raspberrypilearning/bike-gloves/README.md

# default-project-template

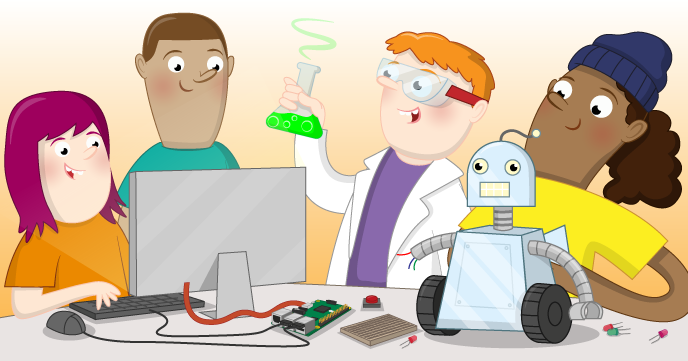
[picture p1: banner.png]
default-project-template


Find the project online at [projects.raspberrypi.org/en/projects/default-project-template](https://projects.raspberrypi.org/en/projects/default-project-template)

## Resources
For project materials and solutions, see [en/resources](https://github.com/raspberrypilearning/default-project-template/tree/master/en/resources) and [en/solutions](https://github.com/raspberrypilearning/default-project-template/tree/master/en/solutions).

## Contributing
See [CONTRIBUTING.md](CONTRIBUTING.md)

## Licence
See [LICENCE.md](LICENCE.md)

## Setting up a Crowdin project

See [CROWDIN.md](CROWDIN.md).
