raspberrypilearning/bike-gloves/en/images/circuit_challenge.jpeg

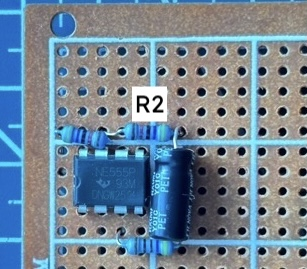
en/images/circuit_challenge.jpeg
