raspberrypilearning/bike-gloves/(list of files, drawings)

Other design files:
en/images/LED_555.fzz
