raspberrypilearning/bike-gloves/en/step_1.md

## What you will make

Create flashing bike gloves and stay safe when riding in the dark!

--- print-only ---

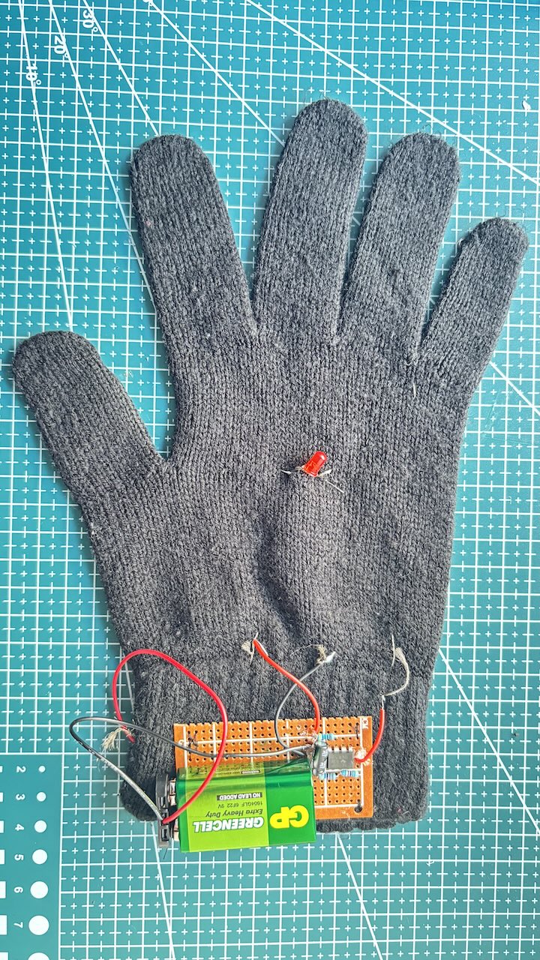
[picture p3: en/images/bike_glove.jpg]
A glove with flashing LEDs on the back, which is controlled by closing two fingers together.


--- /print-only ---

--- no-print ---

<video width="270" height="480" controls autoplay>
<source src="images/bike_glove.mp4" type="video/mp4">
</video>

--- /no-print ---

### You will need:
- Breadboard
- 2 x LED
- 2 x 555 timer
- 4 x 47 kΩ resistors
- 2 x 470 Ω or 330 Ω resistor
- 2 x 10 µF capacitor
- Jumper cables
- 9V battery
- PP3 connector (battery snap)
- Prototype circuit board
- Conductive thread
- Needle
- A pair of gloves
- Soldering kit

**Optional**:
- Potentiometer
- Light dependent resistor (LDR)
- Extra 47 kΩ resistors
