raspberrypilearning/bike-gloves/en/step_2.md

## Make a prototype

### Power the 555 timer

With the notch on the left, the 555 timer pins are:

1: Ground
2: Trigger
3: Output
4: Reset
5: Control
6: Threshold
7: Discharge
8: VCC

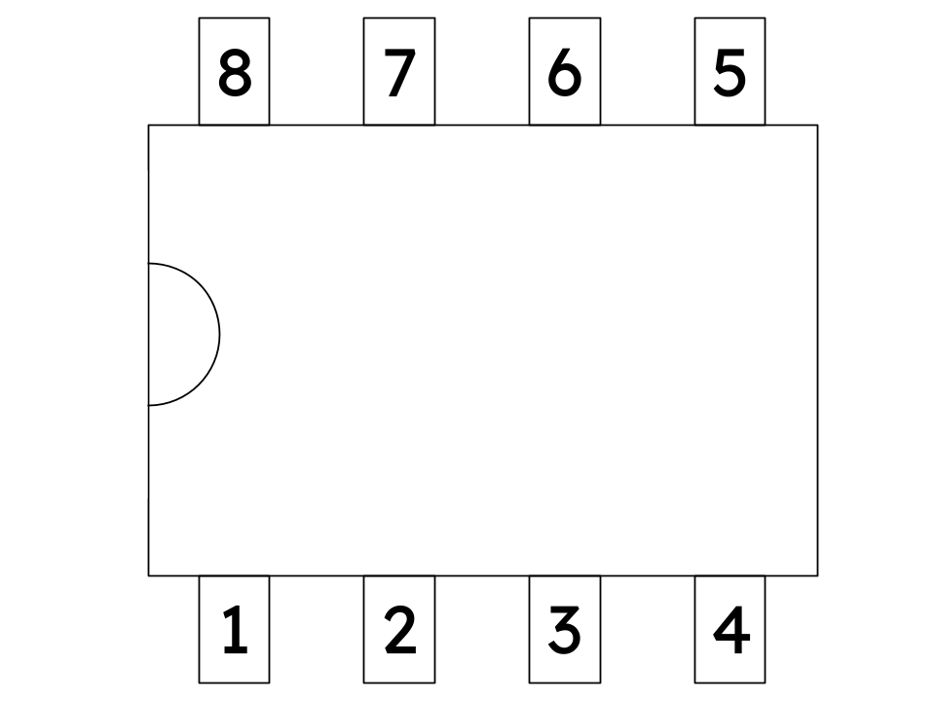
[picture p4: en/images/555_timer_pinout.png]
A 555 timer pinout. Pins 1 to 4 are at the bottom from left to right and pins 5 to 8 are at the top from right to left.


--- task ---

Put the 555 timer in the middle of the breadboard, across the centre gap.

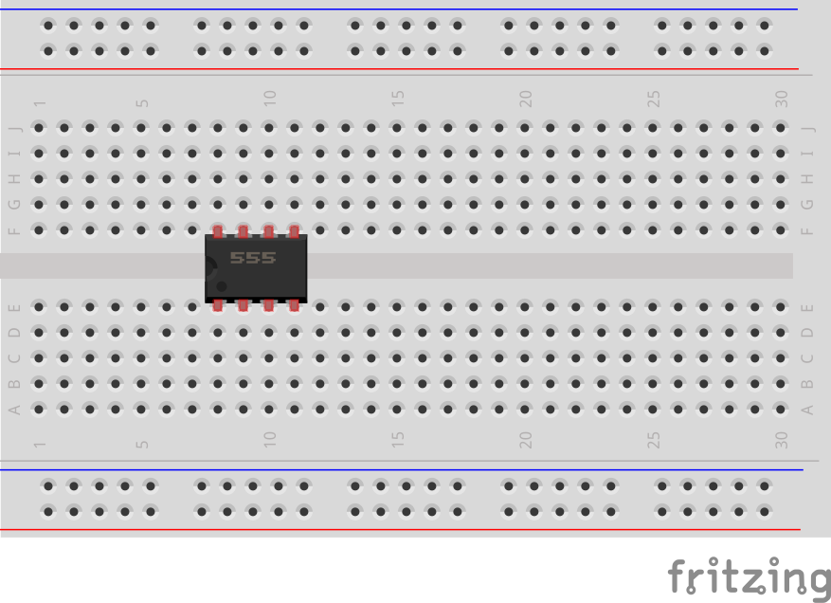
[picture p5: en/images/LED_555-9.png]
A 555 timer positioned across the gap in the middle of a breadboard, with pin 1 in E8 and pin 8 in F8.


--- /task ---

--- task ---

Connect the 555 timer power pins.

Connect **pin 1** to the ground rail.

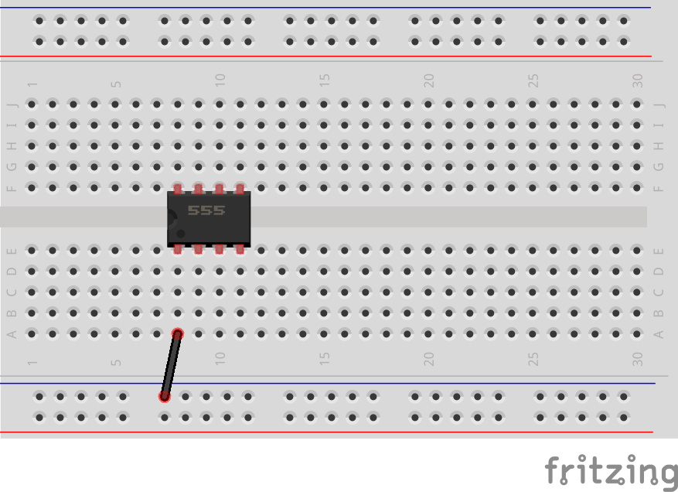
[picture p6: en/images/LED_555-8.png]
A jumper wire has been added to connect A8 to the ground rail.


Connect **pin 8** to the positive rail.

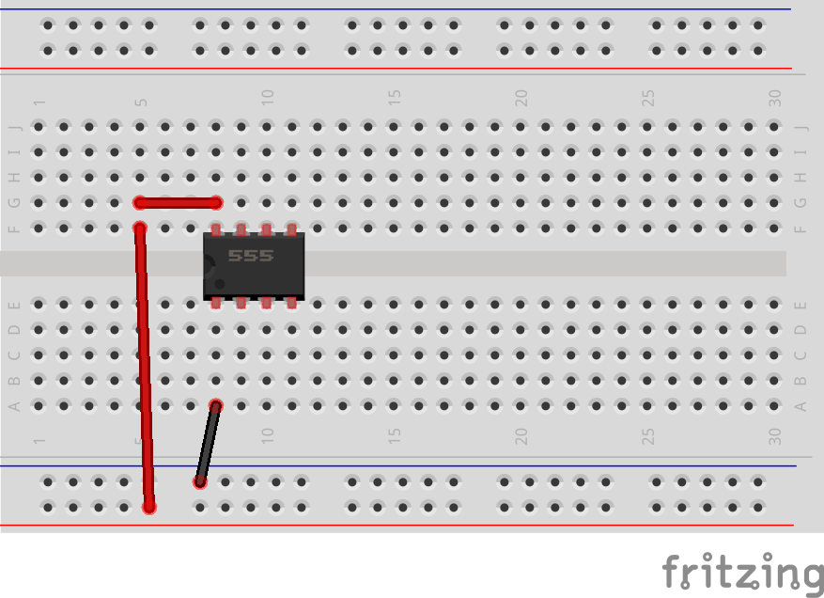
[picture p7: en/images/LED_555-7.png]
Two jumper wires have been added to connect G8 to G5 and F5 to the positive rail.


Connect **pin 4 (reset)** to the positive rail (so it is always enabled).

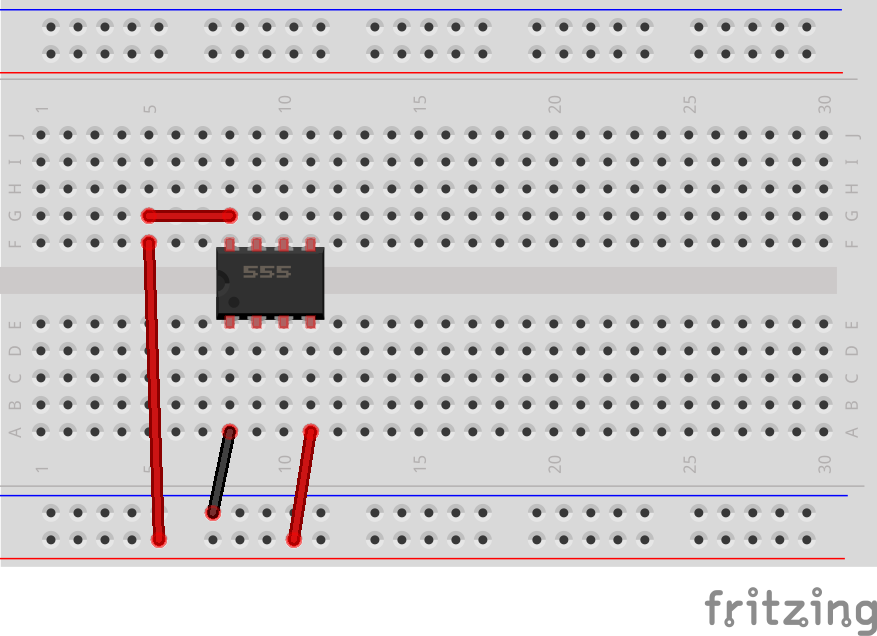
[picture p8: en/images/LED_555-6.png]
A jumper wire has been added to connect A11 to the positive rail.


You will add the battery to the breadboard at the end.

--- /task ---

### Build the timing network

--- task ---

Join **pins 2** and **6** (**trigger** and **threshold**) together.

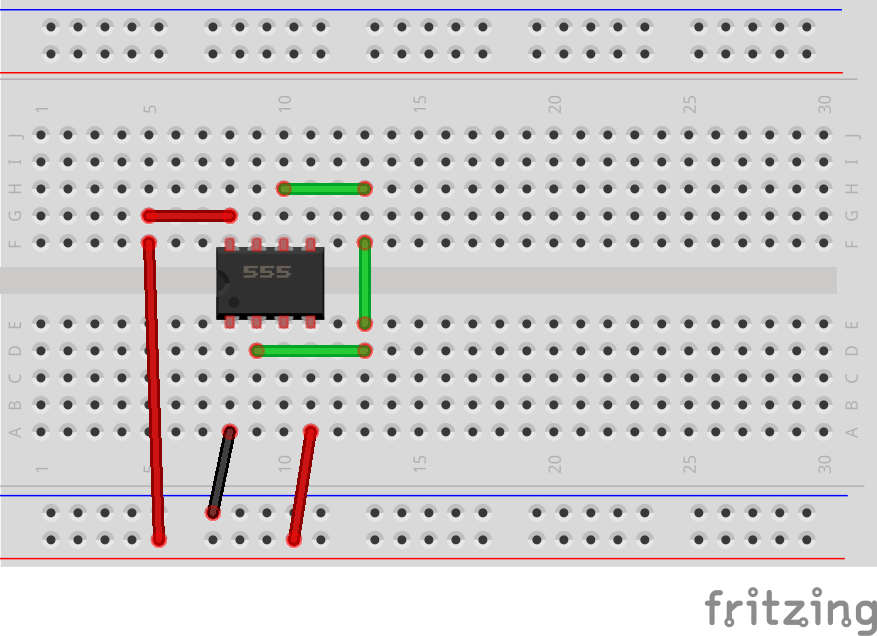
[picture p9: en/images/LED_555-5.png]
Three jumper wires have been added to connect D9 to D13, E13 to F13, and H13 to H10.


--- /task ---

--- task ---

Add two 47kΩ resistors.

The first should connect the positive rail to **pin 7**.

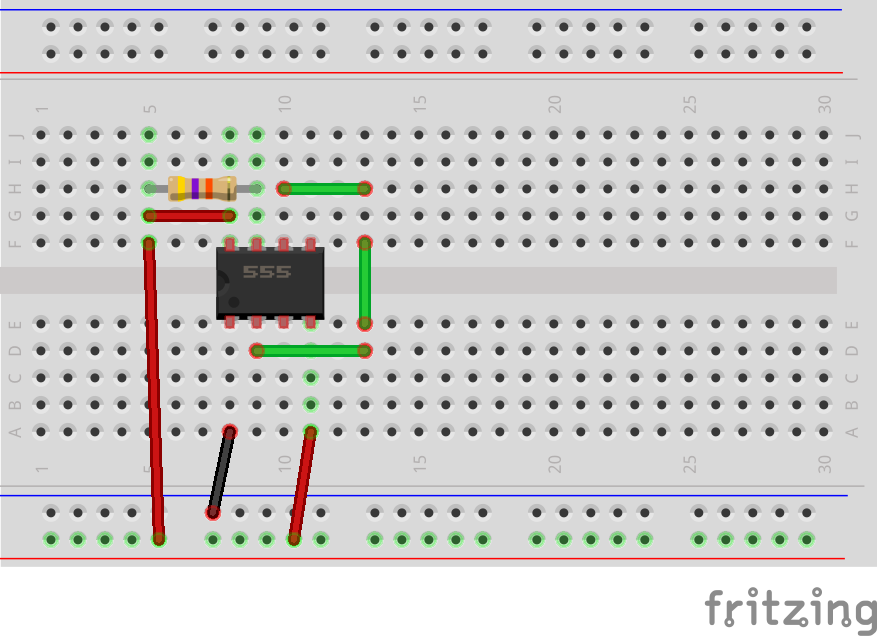
[picture p10: en/images/LED_555-4.png]
A 47kΩ resistor has been added connecting H5 and H9.


The second should connect **pin 7** to **pins 2** and **6** (the joined pins).

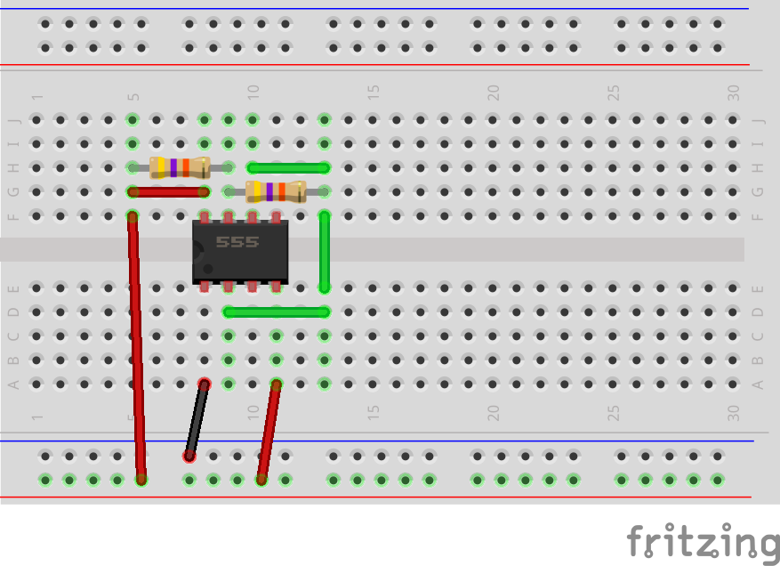
[picture p11: en/images/LED_555-3.png]
A 47kΩ resistor has been added connecting G9 and G13.


--- /task ---

--- task ---

Add the capacitor (10µF).

Connect the positive (long) leg to the joined **pins 2** and **6**.

Connect the negative (short) leg to the ground rail.

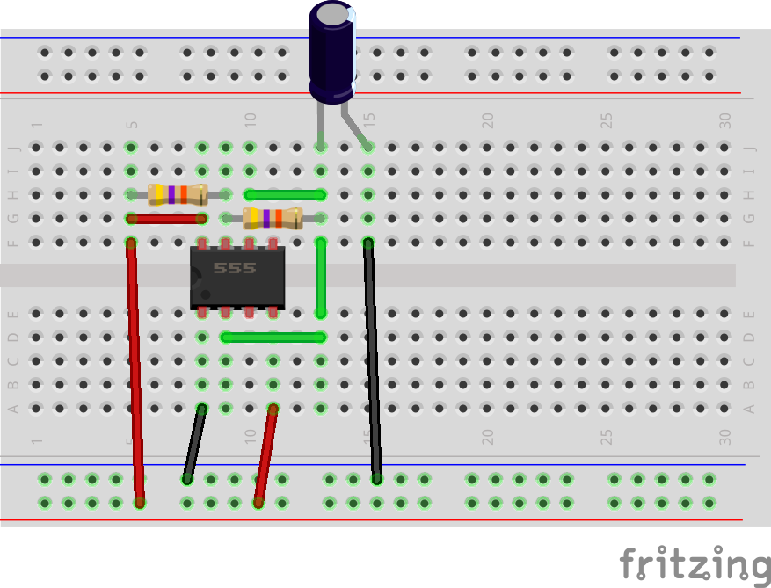
[picture p12: en/images/LED_555-2.png]
A 10µF capacitor has been added, with the long leg in J13 and the short leg in J15. A jumper wire has been added to connect F15 to the ground rail.


--- /task ---

### Add the LED and resistor

--- task ---

Connect one side of the 470Ω resistor to **pin 3 (output)**, and connect the other side of the resistor to the long leg of the LED.

Connect the short leg of the LED to the ground rail.

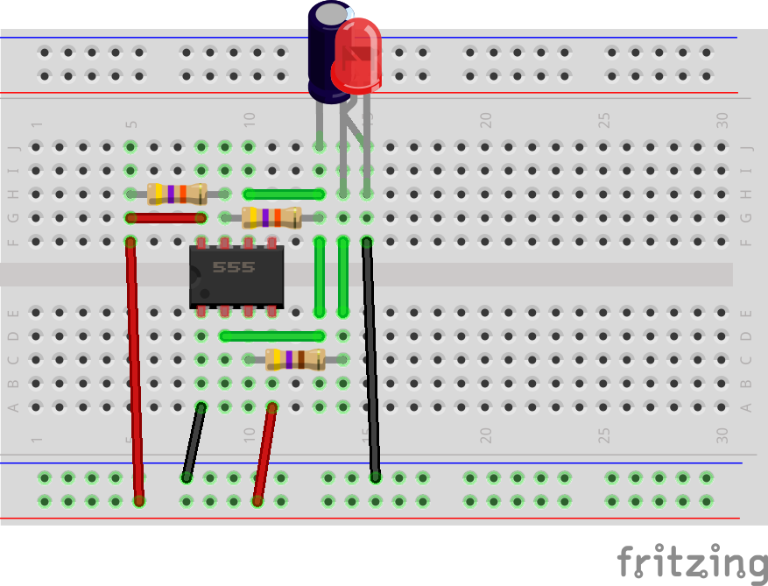
[picture p13: en/images/LED_555-1.png]
An LED has been added, with the long leg in H14 and the short leg in H15, and a resistor has been added in C10 and C14.


--- /task ---

--- task ---

**Test:**

Add the 9V battery and connect the power and ground rails.

Connect the positive terminal of the battery to the red positive rail.

Connect the negative terminal of the battery to the blue ground rail.

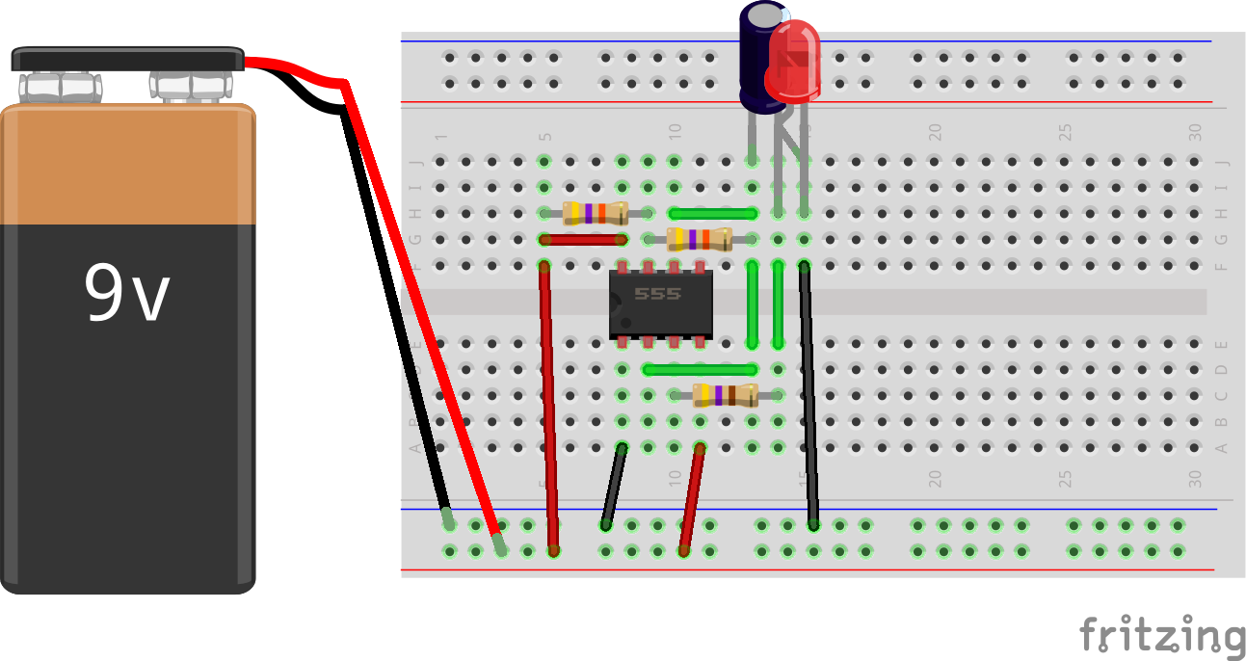
[picture p14: en/images/LED_555.png]
A 9V battery has been connected to the power rails with jumper wires.


The LED should blink once every second — great for making you more visible to other road users!

--- no-print ---

<video width="480" height="270" controls>
<source src="images/LED_555.mp4" type="video/mp4">
</video>

--- /no-print ---

**Debug:** Unplug the battery and check that:

- **Pin 1** is connected to the ground rail, **pin 8** is connected to the positive rail, and **pin 4** is connected to the positive rail
- **Pins 2** and **6** are joined correctly
- The capacitor legs are the correct way around
- The LED legs are the correct way around

--- /task ---
