raspberrypilearning/bike-gloves/en/step_3.md

## Add to your gloves

If you are new to soldering, check out our [Getting started with soldering](https://projects.raspberrypi.org/en/projects/getting-started-with-soldering){:target="_blank"} guide for support.

### Add the components

--- task ---

Using the breadboard as a guide, add the resistors, capacitor and the 555 timer to a prototype circuit board (PCB).

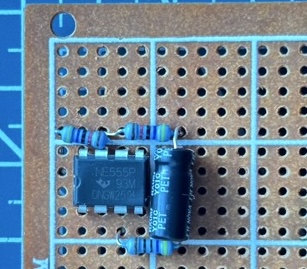
[picture p15: en/images/circuit_1.jpeg]
Components placed on the prototype circuit board.


--- /task ---

### Solder the components

--- task ---

Solder the components to the PCB. You can use resistor legs as positive and negative rails if your PCB does not have them.

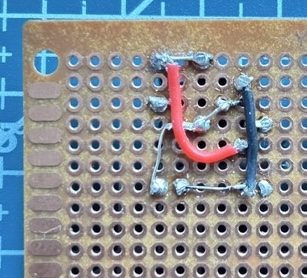
[picture p16: en/images/circuit_2.jpeg]
The back of the PCB with the components soldered.


--- /task ---

### Add the LED

--- task ---

Curl the LED legs into loops and sew them into your glove with conductive thread.

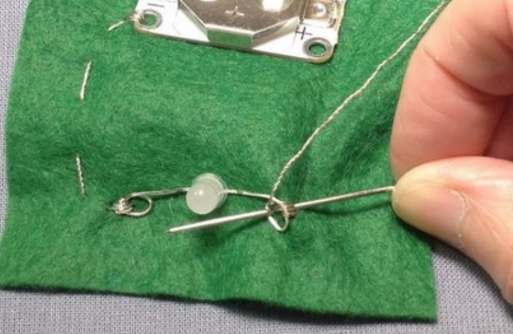
[picture p17: en/images/circuit_4.png]
Sewing the LED legs to the glove with conductive thread.


Make sure there are no sharp edges near your hand. You can trim the legs with snippers.

--- /task ---

--- task ---

Sew the thread from each leg through the back of the glove to the cuff.

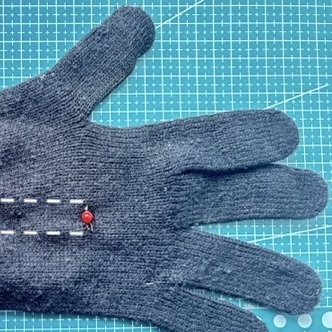
[picture p18: en/images/circuit_5.jpeg]
An example of sewing the thread from each leg through the back of the glove to the cuff.


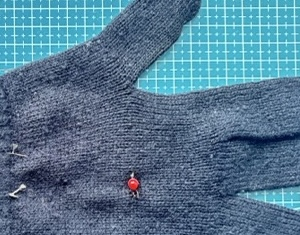
[picture p19: en/images/circuit_6.jpeg]
Conductive thread from the legs of the LED showing at the cuff.


--- /task ---

### Create a switch

--- task ---

Sew conductive thread into the thumb and the little finger of the glove. The pads of thread should touch when you bring them together.

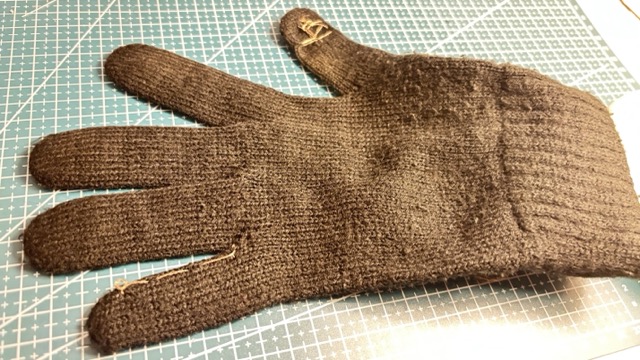
[picture p20: en/images/circuit_3.jpeg]
The glove with a conductive thread pad visible on the thumb.


--- /task ---

--- task ---

Sew the thread from each side of the switch along the back of the glove to the cuff.

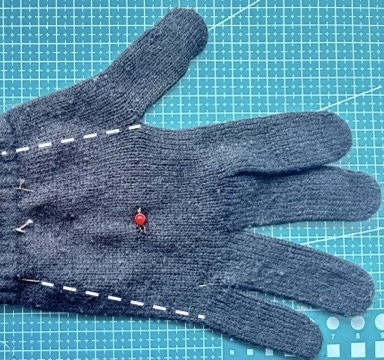
[picture p21: en/images/circuit_6a.jpeg]
An illustration of sewing the thread from the thumb and little finger to the cuff along the back of the glove.


--- /task ---

### Connect the switch

--- task ---

Connect the negative terminal of the 9V battery to the negative rail of your PCB.

Connect the positive terminal of the 9V battery to the conductive thread from the thumb.

Connect the positive rail of the PCB to the conductive thread from the little finger.

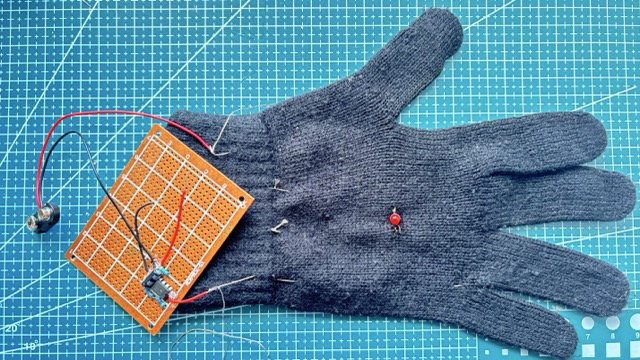
[picture p22: en/images/circuit_7.jpeg]
The positive side of the battery connector has been connected to the conductive thread from the thumb at the cuff of the glove, and the negative side has been connected to the negative rail of the PCB, and the positive rail of the PCB has been connected to the conductive thread from the little fing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


--- /task ---

### Cut the PCB

--- task ---

Cut the PCB in a straight line, leaving space for the 9V battery.

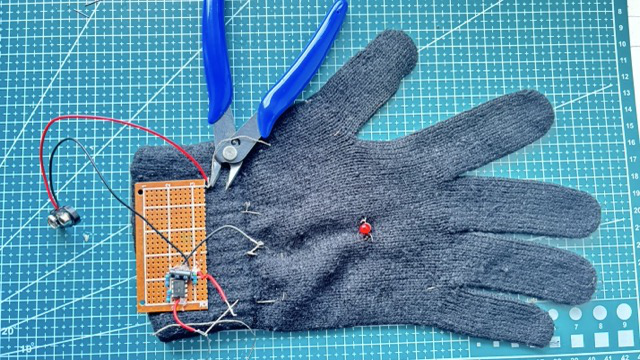
[picture p23: en/images/circuit_8.jpeg]
The PCB has been cut to fit the glove.


This will make it fit on your wrist better when you ride your bike.

--- /task ---

### Connect the LED

--- task ---

Connect the conductive thread from the LED's long leg to the 470Ω resistor.

Connect the conductive thread from the LED's short leg to the PCB's negative rail.

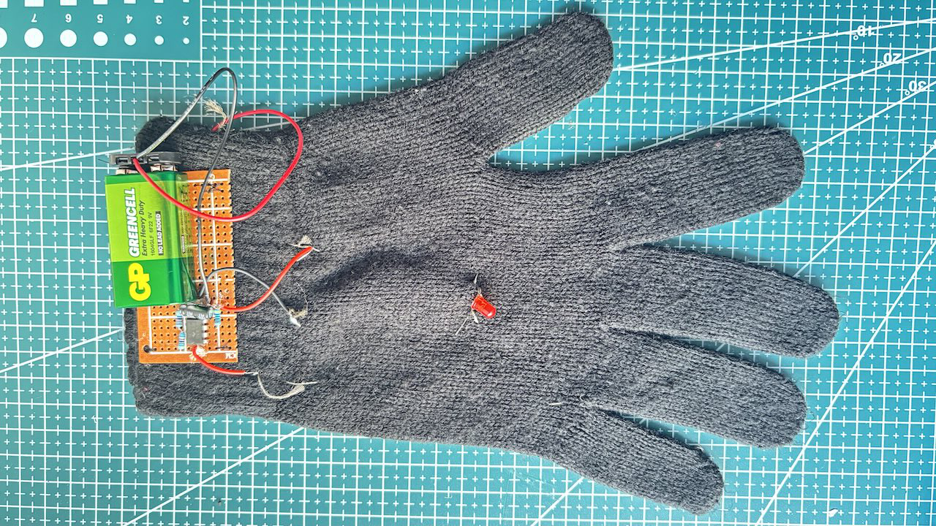
[picture p24: en/images/circuit_9.jpg]
At the cuff of the glove, the conductive thread from the LED has been connected to the resistor and the PCB's negative rail.


--- /task ---

--- task ---

Sew the PCB to the glove and secure the 9V battery to it (we used hot glue).

--- /task ---

--- no-print ---

<video width="270" height="480" controls>
<source src="images/bike_glove_circuit.mp4" type="video/mp4">
</video>

--- /no-print ---
